cmoore42/cue-lights/README.md

# Theatrical Cue Light system

This project contains hardware and firmware designs to build a multi-station cue light system.

Please see the Wiki pages for more information and documentation.
