cmoore42/cue-lights/3D-Models/Hole Test.stl

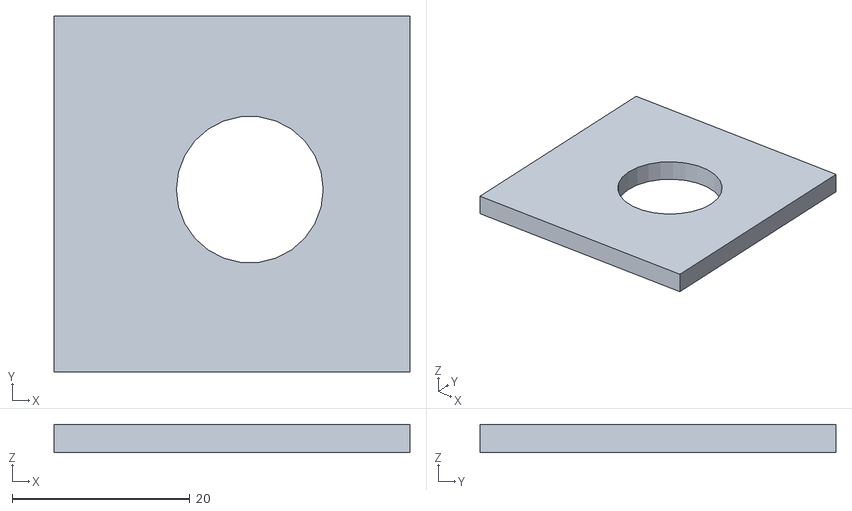
[picture p1: CAD file, 2019-04-12]
3D-Models/Hole Test.stl
40.0 x 40.0 x 3.17
