cmoore42/cue-lights/3D-Models/Master Panel.stl

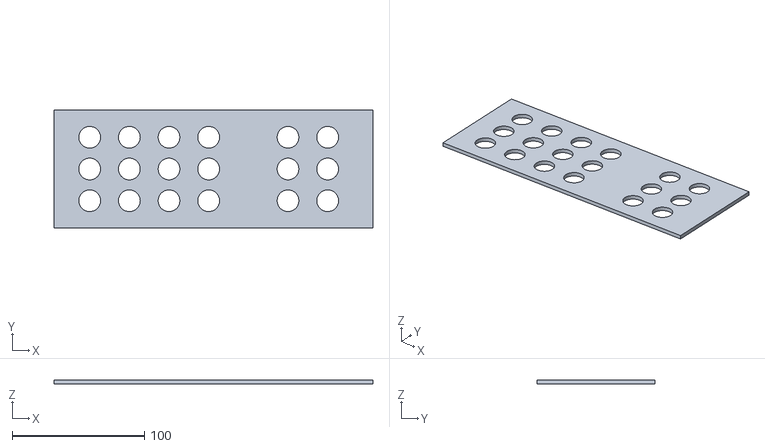
[picture p2: CAD file, 2019-04-12]
3D-Models/Master Panel.stl
241.3 x 89.0 x 3.17
