cmoore42/cue-lights/3D-Models/Slave Panel.stl

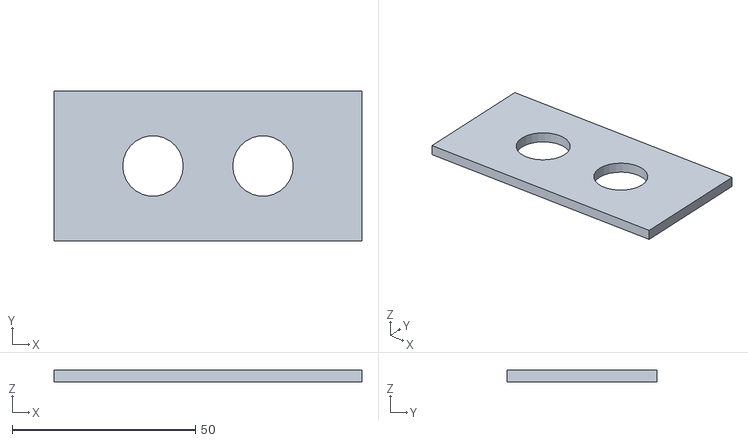
[picture p3: CAD file, 2019-04-12]
3D-Models/Slave Panel.stl
84.0 x 41.0 x 3.17
