cmoore42/cue-lights/(list of files, cad)

Other CAD files:
3D-Models/Hole Test.scad
