cmoore42/cue-lights/hardware/CueLights Rev 2/MainBoard.brd

## EAGLE design hardware/CueLights Rev 2/MainBoard.brd (2019-04-12)

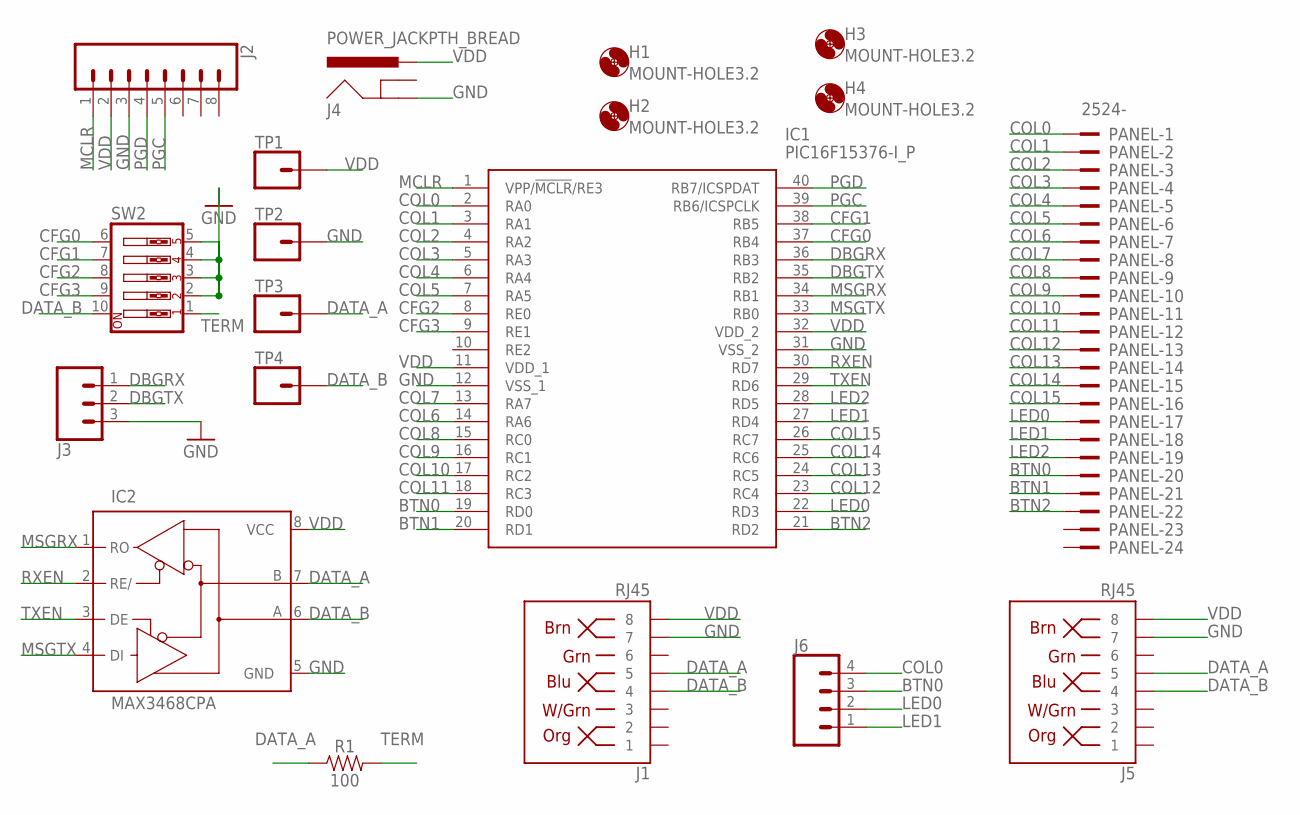
[picture p4: schematic MainBoard.sch]

Parts:
H1, H2, H3, H4: MOUNT-HOLE3.2; 3,2
IC1: PIC16F15376-I_P; DIP1550W56P254L5219H483Q40N
IC2: MAX3468CPA; DIL08
J1, J5: RJ45; RJ45-8
J2: CONN_08"; 1X08
J3: CONN_03; 1X03
J4: POWER_JACKPTH_BREAD; POWER_JACK_PTH_BREAD
J6: CONN_04; 1X04
PANEL: 2524-; PAK100/2500-24
R1: 100; AXIAL-0.3
SW2: SW_DIP-5; EDG-05
TP1, TP2, TP3, TP4: CONN_01; 1X01

Connections:
BTN0: IC1.19 (RD0), J6.3, PANEL.20
BTN1: IC1.20 (RD1), PANEL.21
BTN2: IC1.21 (RD2), PANEL.22
CFG0: IC1.37 (RB4), SW2.6
CFG1: IC1.38 (RB5), SW2.7
CFG2: IC1.8 (RE0), SW2.8
CFG3: IC1.9 (RE1), SW2.9
COL0: IC1.2 (RA0), J6.4, PANEL.1
COL1: IC1.3 (RA1), PANEL.2
COL2: IC1.4 (RA2), PANEL.3
COL3: IC1.5 (RA3), PANEL.4
COL4: IC1.6 (RA4), PANEL.5
COL5: IC1.7 (RA5), PANEL.6
COL6: IC1.14 (RA6), PANEL.7
COL7: IC1.13 (RA7), PANEL.8
COL8: IC1.15 (RC0), PANEL.9
COL9: IC1.16 (RC1), PANEL.10
COL10: IC1.17 (RC2), PANEL.11
COL11: IC1.18 (RC3), PANEL.12
COL12: IC1.23 (RC4), PANEL.13
COL13: IC1.24 (RC5), PANEL.14
COL14: IC1.25 (RC6), PANEL.15
COL15: IC1.26 (RC7), PANEL.16
DATA_A: IC2.7 (B), J1.5, J5.5, R1.P$1 (1), TP3.1
DATA_B: IC2.6 (A), J1.4, J5.4, SW2.10, TP4.1
DBGRX: IC1.36 (RB3), J3.1
DBGTX: IC1.35 (RB2), J3.2
GND: IC1.12 (VSS_1), IC1.31 (VSS_2), IC2.5 (GND), J1.7, J2.3, J3.3, J4.GND, J5.7, SW2.2, SW2.3, SW2.4, SW2.5, TP2.1
LED0: IC1.22 (RD3), J6.2, PANEL.17
LED1: IC1.27 (RD4), J6.1, PANEL.18
LED2: IC1.28 (RD5), PANEL.19
MCLR: IC1.1 (VPP/!MCLR!/RE3), J2.1
MSGRX: IC1.34 (RB1), IC2.1 (RO)
MSGTX: IC1.33 (RB0), IC2.4 (DI)
PGC: IC1.39 (RB6/ICSPCLK), J2.5
PGD: IC1.40 (RB7/ICSPDAT), J2.4
RXEN: IC1.30 (RD7), IC2.2 (RE/)
TERM: R1.P$2 (2), SW2.1
TXEN: IC1.29 (RD6), IC2.3 (DE)
VDD: IC1.11 (VDD_1), IC1.32 (VDD_2), IC2.8 (VCC), J1.8, J2.2, J4.PWR, J5.8, TP1.1

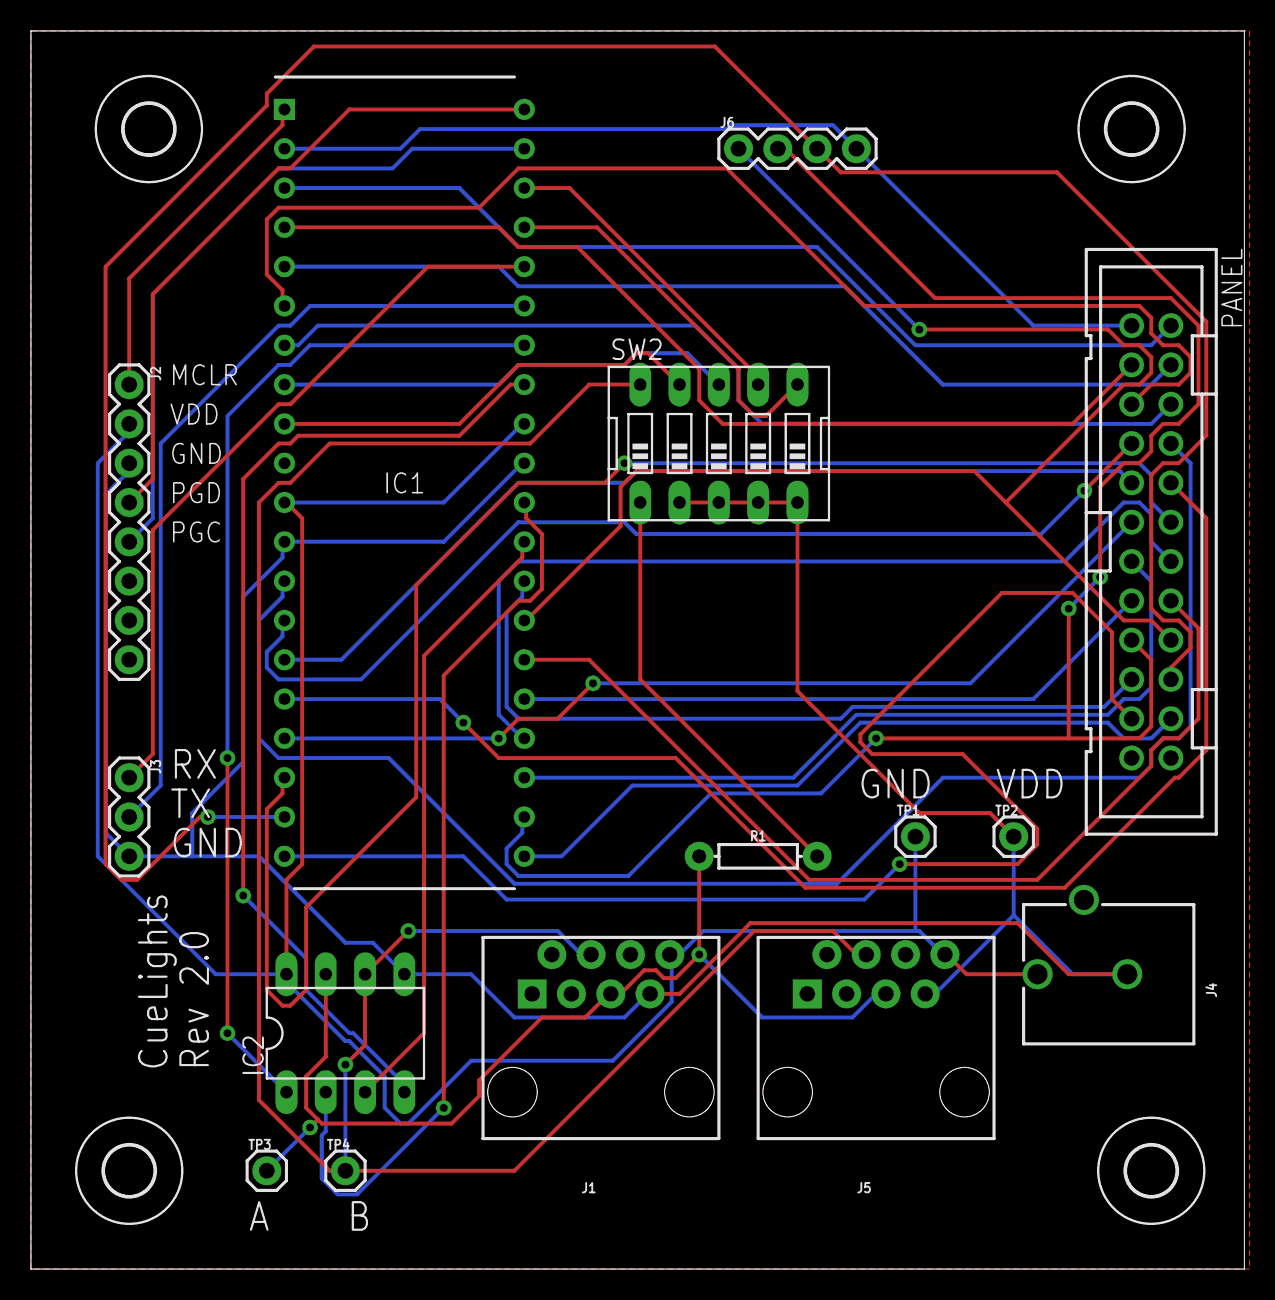
[picture p5: board MainBoard.brd from above]

Board: 2 copper layers, 78.4 x 80.0 mm, 19 parts (0 on the bottom side), 40 nets.
