cmoore42/cue-lights/master.h

/* 
 * File:   master.h
 * Author: chris
 *
 * Created on November 22, 2018, 2:15 PM
 */

#ifndef MASTER_H
#define	MASTER_H

#ifdef	__cplusplus
extern "C" {
#endif

extern void master_loop(void);
extern void master_do_discovery(void);

#ifdef	__cplusplus
}
#endif

#endif	/* MASTER_H */
