cmoore42/cue-lights/slave.h

/* 
 * File:   slave.h
 * Author: chris
 *
 * Created on November 22, 2018, 2:15 PM
 */

#ifndef SLAVE_H
#define	SLAVE_H

#ifdef	__cplusplus
extern "C" {
#endif

extern uint8_t g_slave_state;
    
extern void slave_loop(void);
    


#ifdef	__cplusplus
}
#endif

#endif	/* SLAVE_H */
