cmoore42/cue-lights/(commit log)

2019-01-05 Only call dbg print functions if DEBUG is defined.
2019-01-08 Slave button should only go to READY if already in STANDBY.
2019-04-12 Added the schematic and board layout.
    [MainBoard.brd, MainBoard.sch]
2019-04-12 Added the 3D models
    [Hole Test.scad, Hole Test.stl, Master Panel.scad, Master Panel.stl, Slave Panel.scad, Slave Panel.stl]
